mczerski/MySXRelay/snapshots/front.png

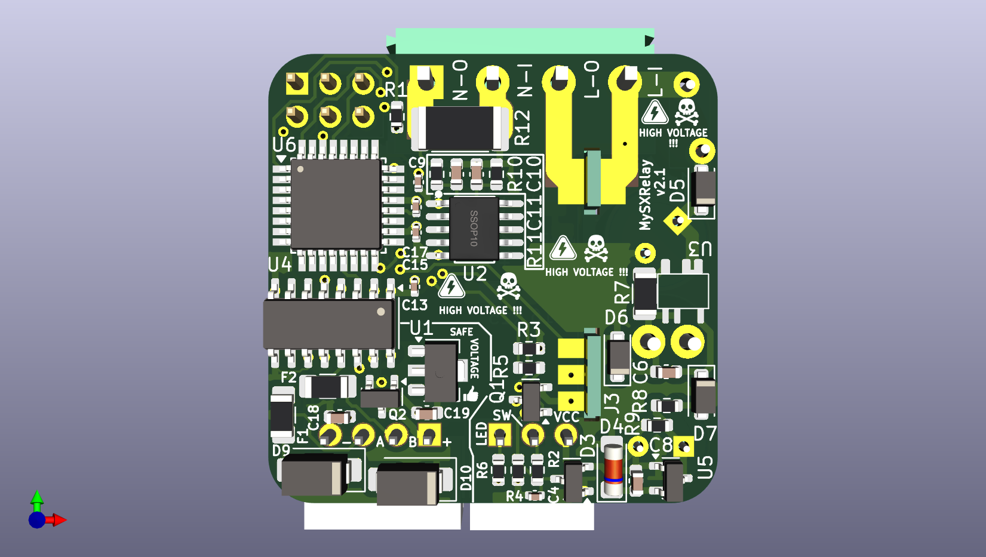
snapshots/front.png
