mczerski/MySXRelay/snapshots/bottom.png

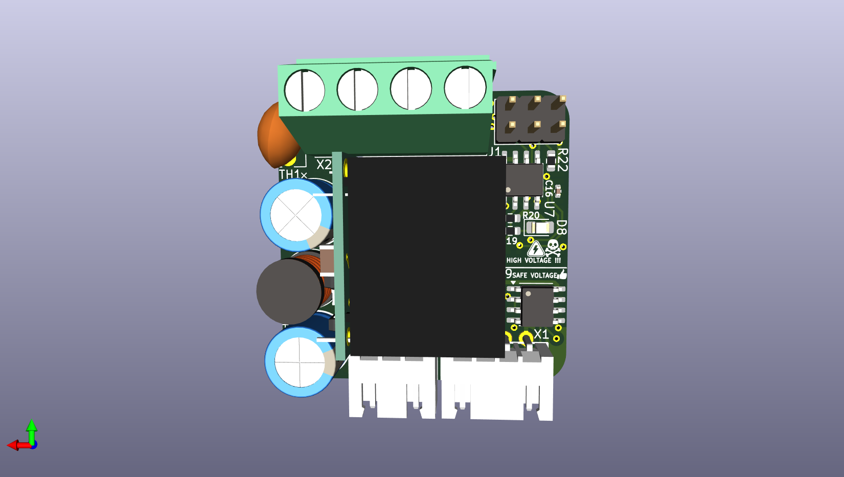
snapshots/bottom.png
