mczerski/MySXRelay/snapshots/bottom-1.png

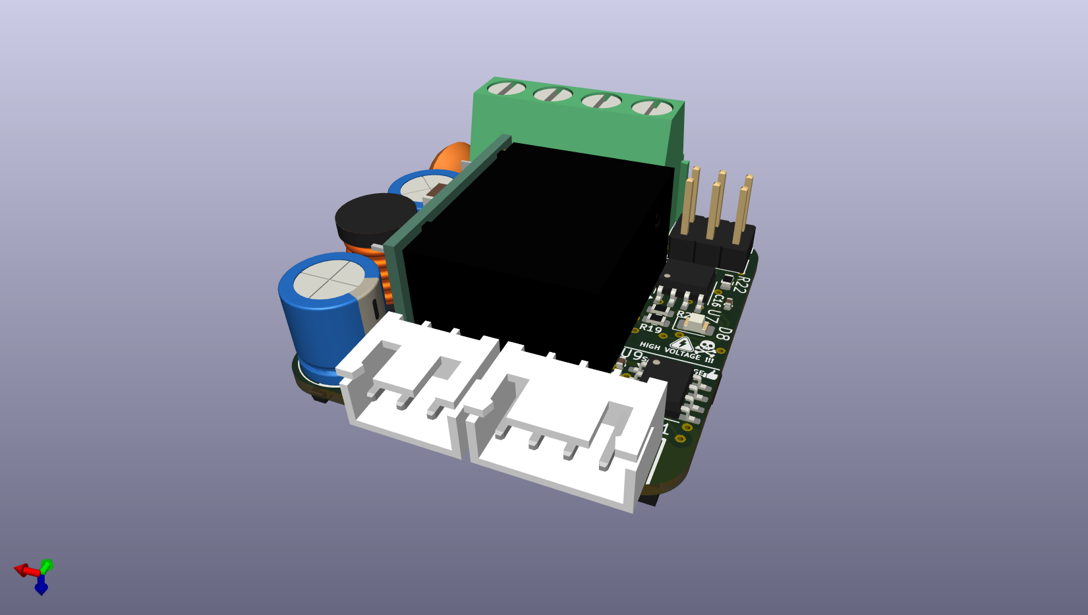
snapshots/bottom-1.png
