mczerski/MySXRelay/snapshots/bottom-2.png

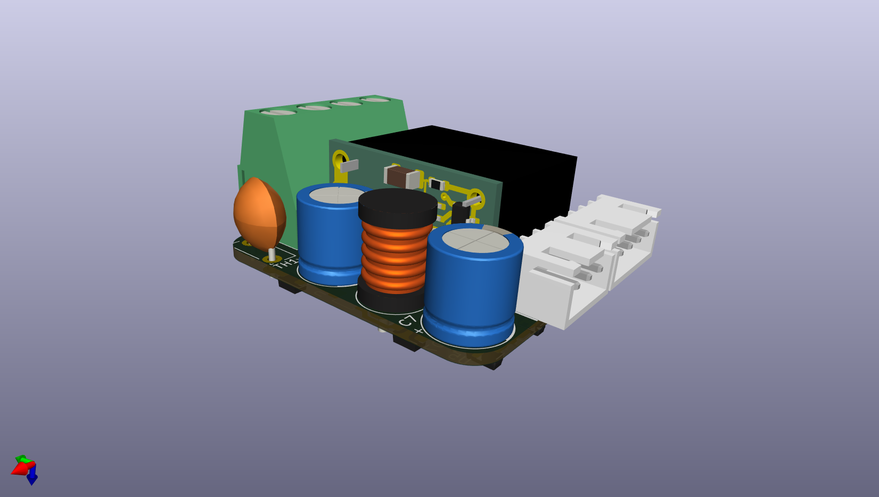
snapshots/bottom-2.png
