mczerski/MySXRelay/snapshots/bottom-3.png

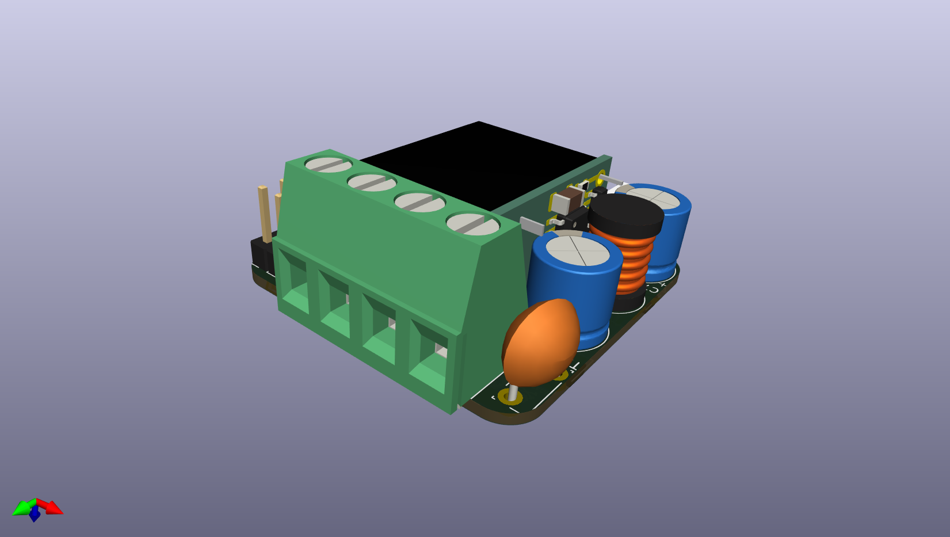
snapshots/bottom-3.png
