mczerski/MySXRelay/snapshots/bottom-4.png

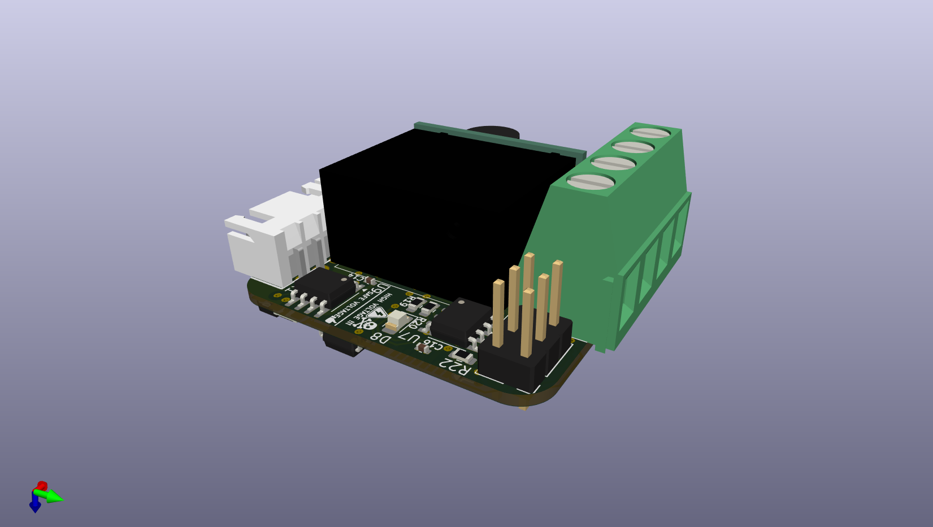
snapshots/bottom-4.png
