mczerski/MySXRelay/snapshots/front-1.png

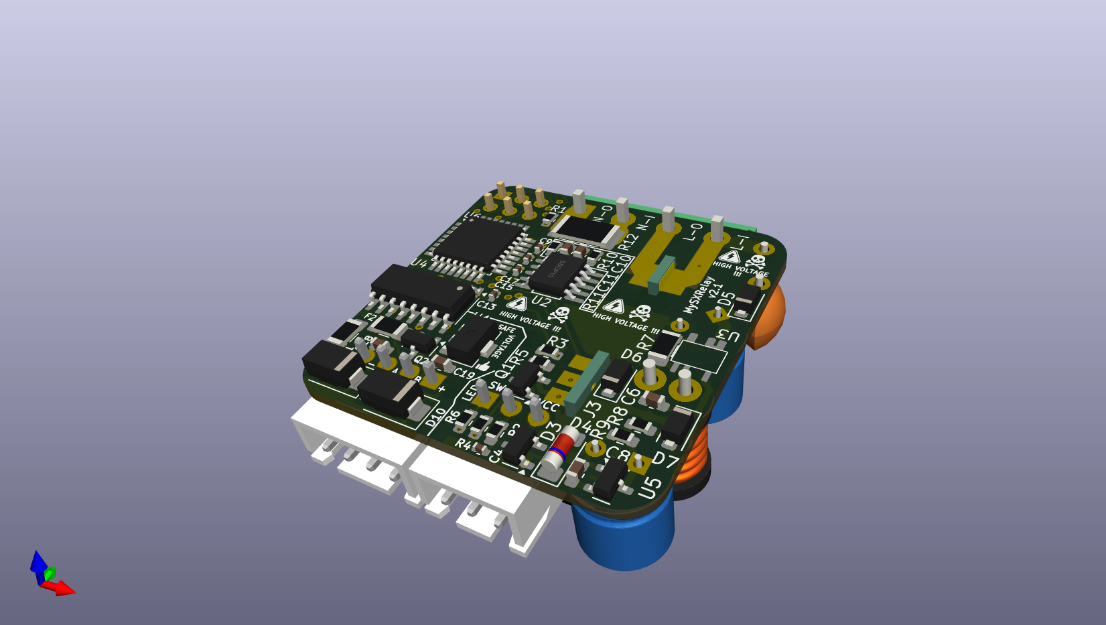
snapshots/front-1.png
