mczerski/MySXRelay/snapshots/front-2.png

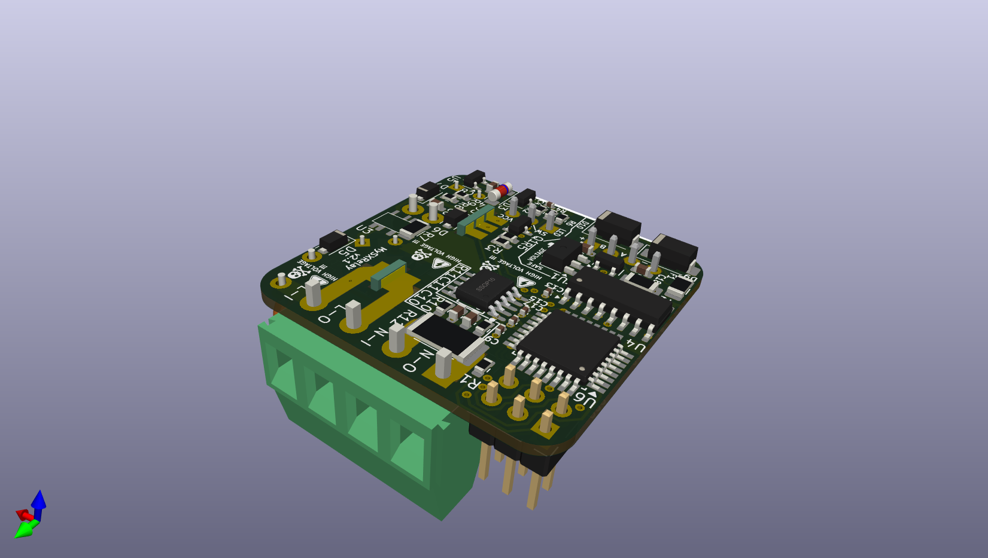
snapshots/front-2.png
