mczerski/MySXRelay/MySXRelay.ods

"Id" | "Oznaczenie" | "Footprint" | "Liczba" | "Oznaczenie" | "Dostawca i numer artykułu" | “Cena/szt” | “Cena”
1 | "R9,R2" | "R_0603_1608Metric" | 2 | "2k" |  | 0.08 | 0.16
2 | "C13,C15,C14,C17,C9,C16" | "C_0402_1005Metric" | 6 | "100n" |  | 0.04 | 0.24
3 | "R19,R6" | "R_0603_1608Metric" | 2 | "1k" |  | 0.08 | 0.16
4 | "U9" | "SOIC-8_3.9x4.9mm_P1.27mm" | 1 | "ST485E" | TME, SP485CN-L, https://www.tme.eu/pl/details/sp485cn-l/uklady-scalone-rs232-rs422-rs485/maxlinear/ | 2.0049 | 2.0049
5 | "U2" | "BL0942" | 1 | "BL0942" | Aliexpress, https://pl.aliexpress.com/item/1005006213868221.html | 2.08 | 2.08
6 | "C8,C19" | "C_0603_1608Metric" | 2 | "10u" |  | 0.12 | 0.24
7 | "U6" | "TQFP-32_7x7mm_P0.8mm" | 1 | "ATmega328PB-A" | TME, ATMEGA328PB-AN, https://www.tme.eu/pl/details/atmega328pb-an/rodzina-avr-8-bit/microchip-technology/ | 8.487 | 8.487
8 | "C10,C11,C12" | "C_0603_1608Metric" | 3 | "68n/16V" |  | 0.2 | 0.6
9 | "D6" | "D_SOD-123F" | 1 | "ES1J/600V" | TME, ES1JSLTR-SMC, https://www.tme.eu/pl/details/es1jsltr-smc/diody-uniwersalne-smd/smc-diode-solutions/es1jsltr/ | 0.1952 | 0.1952
10 | "J3" | "edge_connector" | 1 | "Relay" |  | 11.93 | 11.93
11 | "R1,R4,R3" | "R_0603_1608Metric" | 3 | "10k" |  | 0.08 | 0.24
12 | "R10,R11,R13" | "R_0603_1608Metric" | 3 | "510/1%" | TME, SMD0603-510R-1%, https://www.tme.eu/pl/details/smd0603-510r-1%25/rezystory-smd/royalohm/0603saf5100t5e/ | 0.06 | 0.18
13 | "U5" | "SOT-23" | 1 | "AP2127N-3.3" | TME, AP2120N-3.3TRG1, https://www.tme.eu/pl/details/ap2120n-3.3trg1/stabilizatory-napiecia-nieregulowane-ldo/diodes-incorporated/ | 0.4962 | 0.4962
14 | "U1" | "SOT-89-3" | 1 | "AP2204RA-5.0" | TME, AP2204RA-5.0TRG1, https://www.tme.eu/pl/details/ap2204ra-5.0trg1/stabilizatory-napiecia-nieregulowane-ldo/diodes-incorporated/ | 0.8413 | 0.8413
15 | "Q2" | "SOT-23" | 1 | "BSS84A" | TME, BSS84A-TP, https://www.tme.eu/pl/details/bss84a-tp/tranzystory-z-kanalem-p-smd/micro-commercial-components/ | 0.3876 | 0.3876
16 | "C18,C6" | "C_0603_1608Metric" | 2 | "1u/50V" | TME, CL10A105KB8NNNC, https://www.tme.eu/pl/details/cl10a105kb8nnnc/kondensatory-mlcc-smd/samsung/ | 0.0993 | 0.1986
17 | "D7" | "D_SOD-123F" | 1 | "E1J/600V" | TME, ES1JSLTR-SMC, https://www.tme.eu/pl/details/es1jsltr-smc/diody-uniwersalne-smd/smc-diode-solutions/es1jsltr/ | 0.1952 | 0.1952
18 | "D4" | "D_MiniMELF" | 1 | "3.6V" | TME, ZMM3.6-DIO, https://www.tme.eu/pl/details/zmm3.6-dio/diody-zenera-smd/diotec-semiconductor/zmm3-6/ | 0.0904 | 0.0904
19 | "U4" | "SOIC-16_3.9x9.9mm_P1.27mm" | 1 | "Si8642BB-B-IS1" | TME, PAI142M31, https://www.tme.eu/pl/details/pai142m31/uklady-scalone-interfejsy-pozostale/2pai-semi/p142m31/ | 7.6137 | 7.6137
20 | "D5" | "D_SOD-123F" | 1 | "1n4007/1000V" | TME, 1N4007FLTR-SMC, https://www.tme.eu/pl/details/1n4007fltr-smc/diody-uniwersalne-smd/smc-diode-solutions/1n4007fltr/ | 0.5093 | 0.5093
21 | "R12" | "R_2512_6332Metric_Pad1.40x3.35mm_HandSolder" | 1 | "0R001/1%" | TME, LR2512-R001-1%-2W, https://www.tme.eu/pl/details/lr2512-r001-1%25-2w/rezystory-smd/royalohm/lr122wf100nt4e/ | 1.3665 | 1.3665
22 | "U3" | "SOT-33-5A" | 1 | "BP2525X" | Aliexpress, https://pl.aliexpress.com/item/1005005266072461.html | 1.1 | 1.1
23 | "D8" | "LED_0805_2012Metric_Pad1.15x1.40mm_HandSolder" | 1 | "LED" |  | 0.274 | 0.274
24 | "R8" | "R_0603_1608Metric" | 1 | "100" |  | 0.08 | 0.08
25 | "R7" | "R_1206_3216Metric" | 1 | "0R3" | TME, ERJ8BQFR30V, https://www.tme.eu/pl/details/erj8bqfr30v/rezystory-smd/panasonic/ | 0.5984 | 0.5984
26 | "D10,D9" | "D_SMA" | 2 | "SMAJ11CA" | TME, SMAJ11CA-13-F, https://www.tme.eu/pl/details/smaj11ca-13-f/diody-tvs-smd-dwukierunkowe/diodes-incorporated/ | 0.4207 | 0.8414
27 | "R22,R20" | "R_0603_1608Metric" | 2 | "1M" |  | 0.08 | 0.16
28 | "C5" | "CP_Radial_D8.0mm_P3.50mm" | 1 | "2.2u/400V" | TME, GRC00PB2R22WTFL, https://www.tme.eu/pl/details/grc00pb2r22wtfl/kondensatory-elektrolityczne-tht/vishay/ | 0.7161 | 0.7161
29 | "R14,R18,R16,R17,R15" | "R_1206_3216Metric" | 5 | "390k/1%" | TME, SMD1206-390K-1%, https://www.tme.eu/pl/details/smd1206-390k-1%25/rezystory-smd/royalohm/1206s4f3903t5e/ | 0.10065 | 0.50325
30 | "J1" | "PinHeader_2x03_P2.54mm_Vertical" | 1 | "AVR ISP" |  | 0.26 | 0.26
31 | "X3" | "JST-XH_S_3P-2.54MM" | 1 | "Switch/LED" | Allegro, https://allegro.pl/oferta/jst-xh-2-54mm-3pin-wtyczka-z-kablami-gniazdo-katowe-14981161904 | 2.6 | 2.6
32 | "F2,F1" | "Fuse_1206_3216Metric_Pad1.42x1.75mm_HandSolder" | 2 | "Polyfuse" | TME, PTS120660V005, https://www.tme.eu/pl/details/pts120660v005/bezpieczniki-polimerowe-smd/eaton-bussmann/ | 0.5793 | 1.1586
33 | "U7" | "SOIC-8_3.9x4.9mm_P1.27mm" | 1 | "AT25xxx" | TME, GD25D05BTIG, https://www.tme.eu/pl/details/gd25d05btig/pamieci-flash-szeregowe/gigadevice/ | 0.524 | 0.524
34 | "TH1" | "Fuse_Bourns_MF-RG300" | 1 | "ERF-LX005V2" | TME, LX005-V2, https://www.tme.eu/pl/details/lx005-v2/bezpieczniki-polimerowe-tht/ece/erf-lx005v2/ | 1.0529 | 1.0529
35 | "Q1" | "SOT-23" | 1 | "2N7002" | TME, 2N7002A-DIO, https://www.tme.eu/pl/details/2n7002a-dio/tranzystory-z-kanalem-n-smd/diotec-semiconductor/2n7002a/ | 0.1684 | 0.1684
36 | "C4" | "C_0402_1005Metric" | 1 | "100n/50V" | TME, GCM155R71H104KE02D, https://www.tme.eu/pl/details/gcm155r71h104ke02d/kondensatory-mlcc-smd/murata/ | 0.0758 | 0.0758
37 | "C7" | "CP_Radial_D8.0mm_P3.50mm" | 1 | "470u/10V" | TME, PF1A471MNN08B5, https://www.tme.eu/pl/details/pf1a471mnn08b5/kondensatory-elektrolityczne-tht/elite/ | 0.2723 | 0.2723
38 | "L1" | "L_Radial_D7.0mm_P3.00mm" | 1 | "330u" | TME, COIL0507-0.33, https://www.tme.eu/pl/details/coil0507-0.33/dlawiki-pionowe/ferrocore/ | 1.4674 | 1.4674
39 | "X2" | "TerminalBlock_Phoenix_MKDS-1,5-4-5.08_1x04_P5.08mm_Horizontal" | 1 | "Mains" | TME, XY301V-2P, https://www.tme.eu/pl/details/xy301v-2p/listwy-zaciskowe-do-druku/xinya/xy301v-2p-5-00/ | 1.1224 | 1.1224
40 | "D3" | "SOT-23" | 1 | "BAT54S" | TME, BAT54S, https://www.tme.eu/pl/details/bat54s-dio/diody-schottky-smd/diotec-semiconductor/bat54s/ | 0.1535 | 0.1535
41 | "X1" | "JST-XH_S_4P-2.54MM-PIN1-RIGHT" | 1 | "RS485" | Allegro, https://allegro.pl/oferta/jst-xh-2-54mm-4pin-wtyczka-z-kablami-gniazdo-katowe-14981142802 | 2.8 | 2.8
42 | "R5" | "R_0603_1608Metric" | 1 | "27" |  | 0.08 | 0.08
43 | PCB |  | 1 |  | Jlcpcb | 1.2185 | 1.2185
 |  |  |  |  |  |  | 55.44285 | Suma
