mczerski/MySXRelay/3dshapes/bistable-relay.step

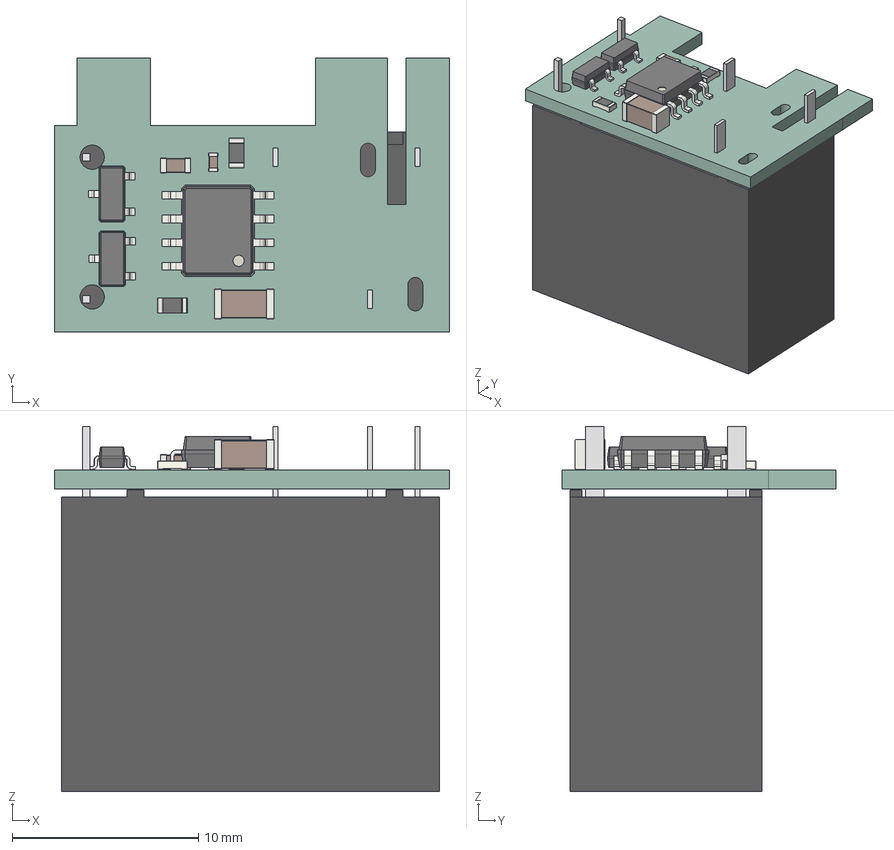
[picture p9: CAD file, 2026-10-02]
3dshapes/bistable-relay.step
21.2 x 14.7 x 19.6 mm
C_0603_1608Metric
C_1206_3216Metric
R_0603_1608Metric x 2
SOT_23 x 2
SOIC_8_39x49mm_P127mm
C_0402_1005Metric
G5Q_14_EU
bistable-relay_PCB
