mczerski/MySXRelay/3dshapes/JST - XH - Thru (R) - 2Pin - 2.54mm.stp

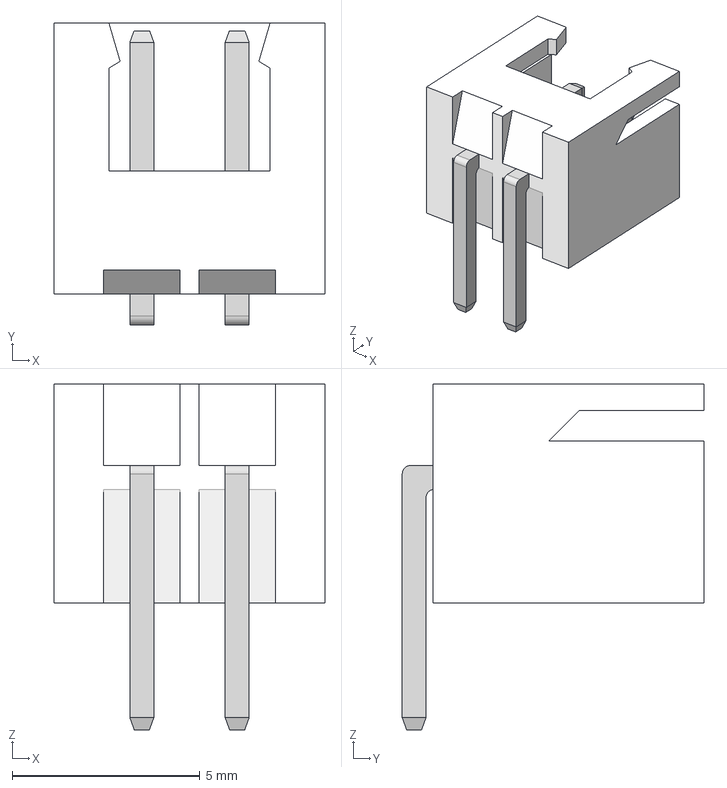
[picture p10: CAD file, 2026-09-26]
3dshapes/JST - XH - Thru (R) - 2Pin - 2.54mm.stp
7.21 x 8.04 x 9.22 mm
