mczerski/MySXRelay/3dshapes/EFR-LX005V2.step

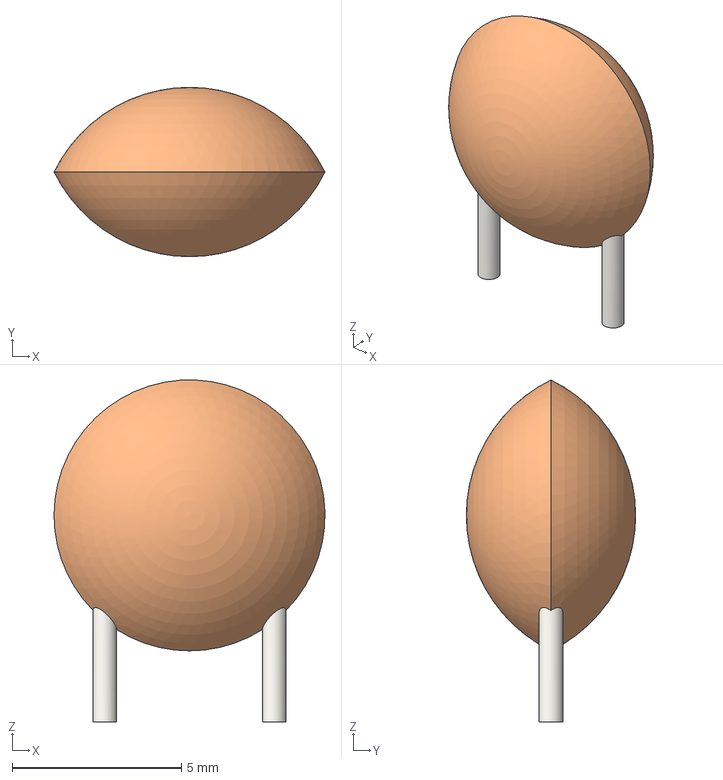
[picture p11: CAD file, 2024-11-26]
3dshapes/EFR-LX005V2.step
8.00 x 5.00 x 10.1 mm
