mczerski/MySXRelay/3dshapes/JST - XH - Thru (R) - 4Pin - 2.54mm.stp

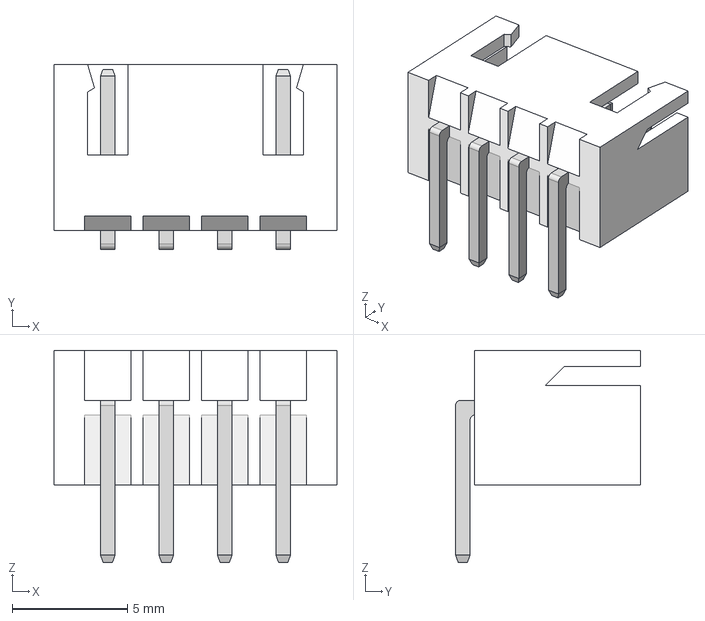
[picture p12: CAD file, 2024-11-03]
3dshapes/JST - XH - Thru (R) - 4Pin - 2.54mm.stp
12.3 x 8.04 x 9.22 mm
