mczerski/MySXRelay/3dshapes/JST - XH - Thru (R) - 3Pin - 2.54mm.stp

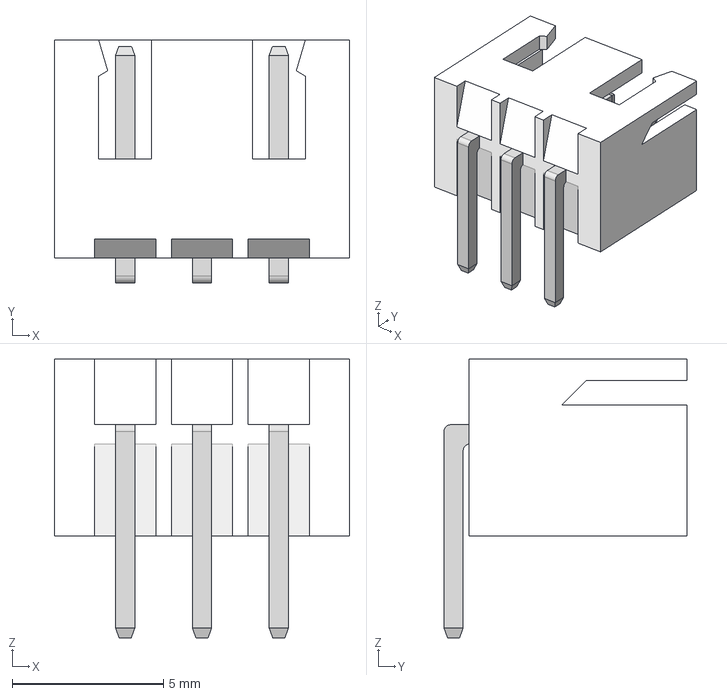
[picture p13: CAD file, 2024-11-03]
3dshapes/JST - XH - Thru (R) - 3Pin - 2.54mm.stp
9.75 x 8.04 x 9.22 mm
