mczerski/MySXRelay/3dshapes/MSTB_2,5_4-G.stp

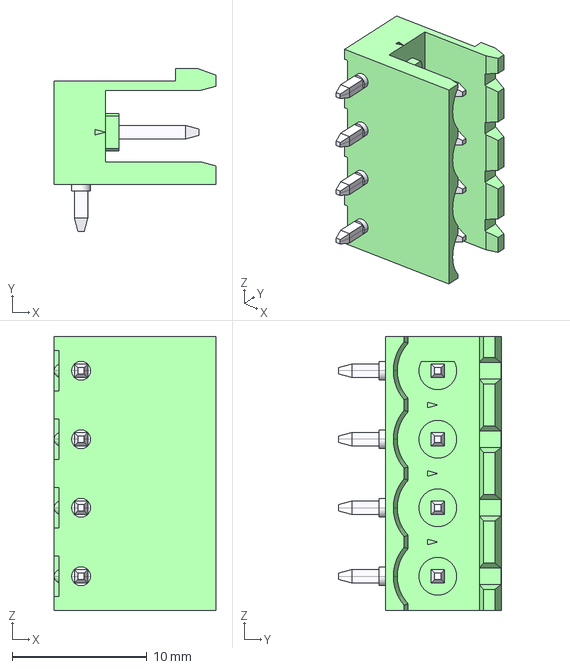
[picture p14: CAD file, 2024-10-23]
3dshapes/MSTB_2,5_4-G.stp
12.0 x 12.1 x 20.3 mm
