mczerski/MySXRelay/doc/ROYALOHM-FRN.pdf

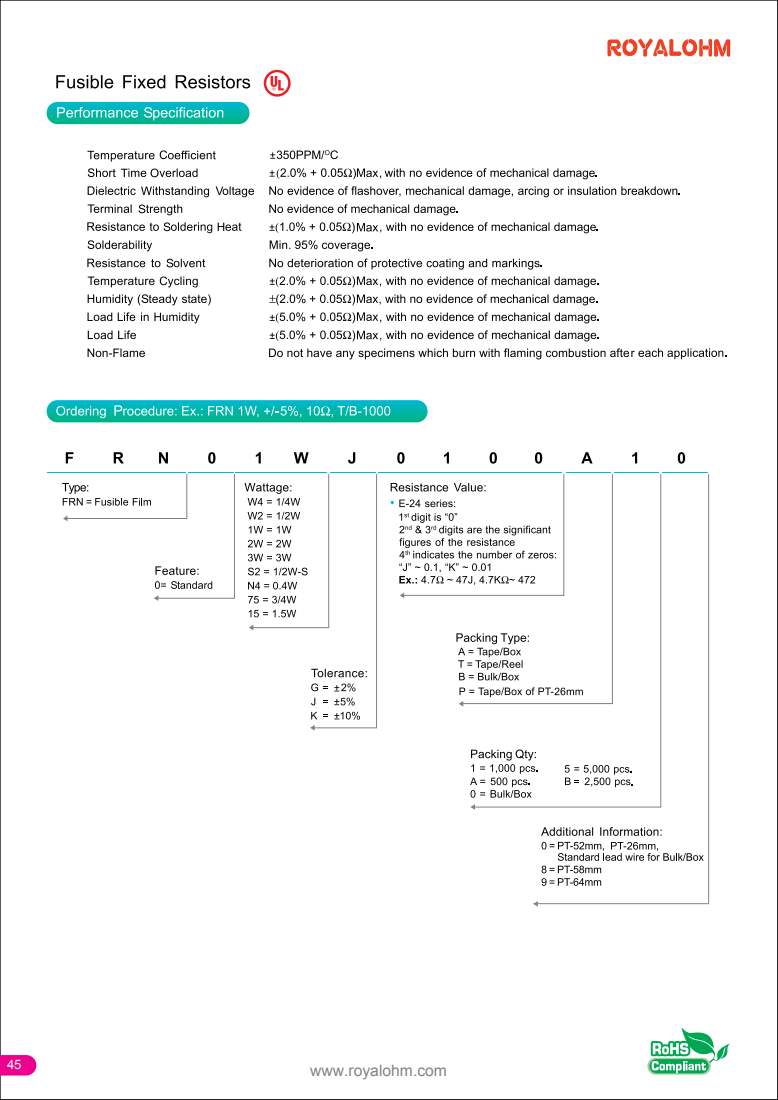
[picture p15: page 1]
www.royalohm.com

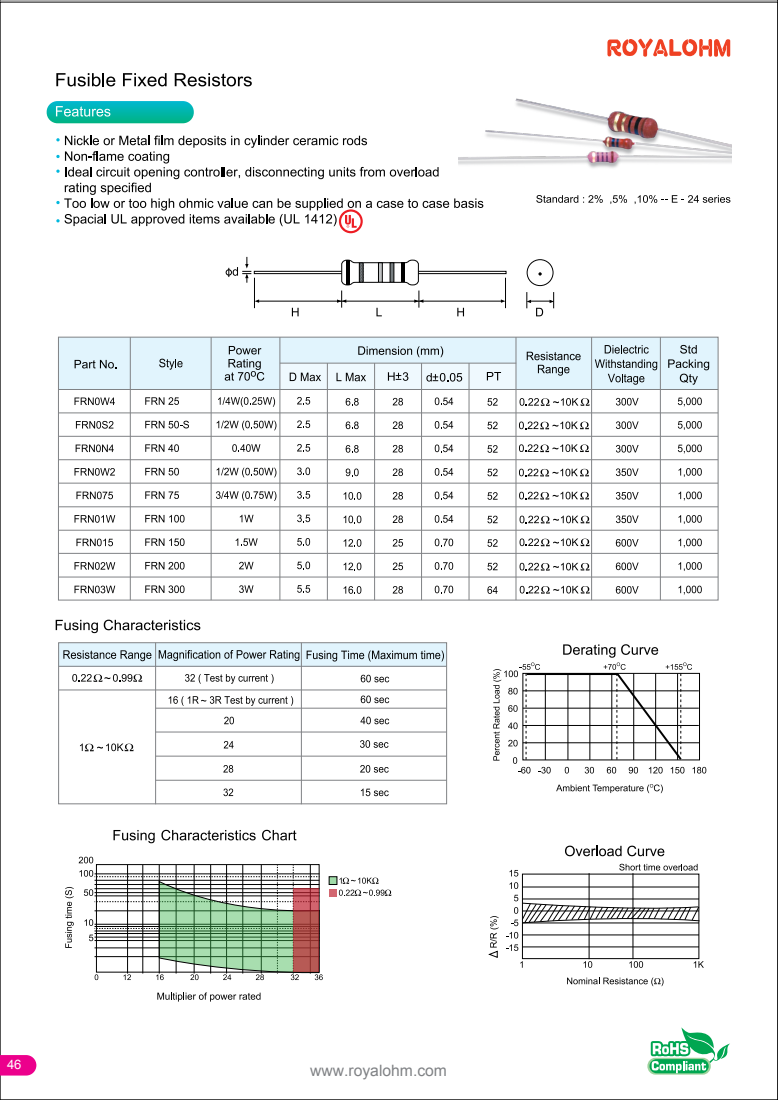
[picture p16: page 2]
www.royalohm.com
