mczerski/MySXRelay/MySXRelay.kicad_pcb

## KiCad design MySXRelay.kicad_pcb (2026-10-02)

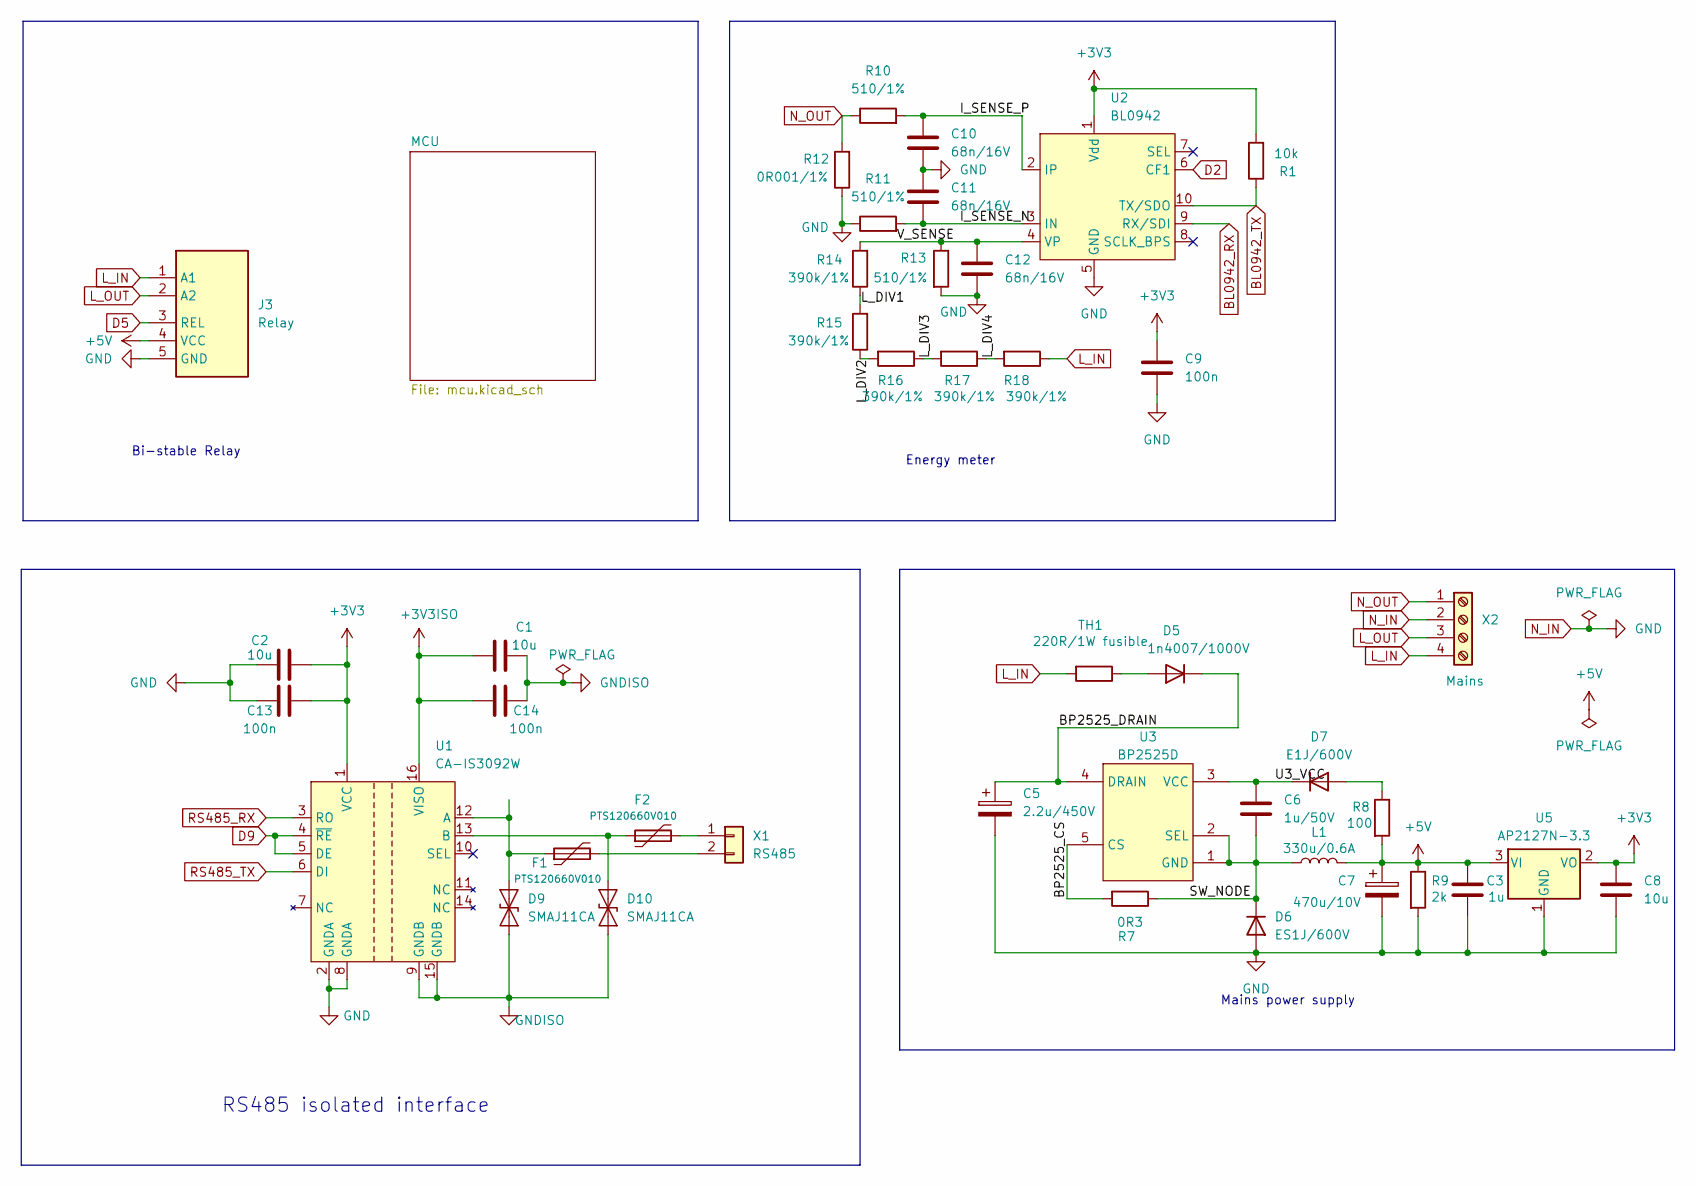
[picture p17: schematic MySXRelay.kicad_sch]

Parts:
C1, C2, C8: 10u; C_0603_1608Metric
C3: 1u; C_0603_1608Metric
C5: 2.2u/450V; CP_Radial_D8.0mm_P3.50mm
C6: 1u/50V; C_0603_1608Metric
C7: 470u/10V; CP_Radial_D8.0mm_P3.50mm
C9, C13, C14: 100n; C_0402_1005Metric
C10, C11, C12: 68n/16V; C_0603_1608Metric
D5: 1n4007/1000V; D_SOD-123F
D6: ES1J/600V; D_SOD-123F
D7: E1J/600V; D_SOD-123F
D9, D10: SMAJ11CA; D_SMA
F1, F2: PTS120660V010; Fuse_1206_3216Metric_Pad1.42x1.75mm_HandSolder
J3: Relay; edge_connector
L1: 330u/0.6A; L_Radial_D7.5mm_P3.00mm_Ferrocore_COIL0608
R1: 10k; R_0603_1608Metric
R7: 0R3; R_1206_3216Metric
R8: 100; R_0603_1608Metric
R9: 2k; R_0603_1608Metric
R10, R11, R13: 510/1%; R_0603_1608Metric
R12: 0R001/1%; R_2512_6332Metric_Pad1.40x3.35mm_HandSolder
R14, R15, R16, R17, R18: 390k/1%; R_1206_3216Metric
TH1: 220R/1W fusible; R_Axial_DIN0207_L6.3mm_D2.5mm_P5.08mm_Vertical
U1: CA-IS3092W; SOIC-16W_7.5x10.3mm_P1.27mm
U2: BL0942
U3: BP2525D; SOT-33-5A
U5: AP2127N-3.3; SOT-23
X1: RS485; JST-XH_S_2P-2.54MM
X2: Mains; TerminalBlock_Phoenix_MKDS-1,5-4-5.08_1x04_P5.08mm_Horizont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

Connections:
+3V3: C2.2, C8.1, C9.1, C13.2, R1.2, U1.1 (VCC), U2.1 (Vdd), U5.2 (VO); also elsewhere on the board
+3V3ISO: C1.1, C14.1, U1.16 (VISO)
+5V: C3.1, C7.1, J3.4 (VCC), L1.2, R8.2, R9.1, U5.3 (VI)
/BP2525_CS: R7.2, U3.5 (CS)
/BP2525_DRAIN: C5.1, D5.1 (K), U3.4 (DRAIN)
/I_SENSE_N: C11.2, R11.2, U2.3 (IN)
/I_SENSE_P: C10.1, R10.2, U2.2 (IP)
/L_DIV1: R14.1, R15.2
/L_DIV2: R15.1, R16.2
/L_DIV3: R16.1, R17.2
/L_DIV4: R17.1, R18.2
/SW_NODE: C6.2, D6.1 (K), L1.1, R7.1, U3.1 (GND), U3.2 (SEL)
/U3_VCC: C6.1, D7.1 (K), U3.3 (VCC)
/V_SENSE: C12.1, R13.1, R14.2, U2.4 (VP)
BL0942_RX: U2.9 (RX/SDI); also elsewhere on the board
BL0942_TX: R1.1, U2.10 (TX/SDO); also elsewhere on the board
D2: U2.6 (CF1); also elsewhere on the board
D5: J3.3 (REL); also elsewhere on the board
D9: U1.4 (~RE), U1.5 (DE); also elsewhere on the board
GNDISO: C1.2, C14.2, D9.1 (A1), D10.1 (A1), U1.9 (GNDB), U1.15 (GNDB)
L_IN: J3.1 (A1), R18.1, TH1.2, X2.4
L_OUT: J3.2 (A2), X2.3
N_IN: C2.1, C3.2, C5.2, C7.2, C8.2, C9.2, C10.2, C11.1, C12.2, C13.1, D6.2 (A), J3.5 (GND), R9.2, R11.1, R12.1, R13.2, U1.2 (GNDA), U1.8 (GNDA), U2.5 (GND), U5.1 (GND), X2.2; also elsewhere on the board
N_OUT: R10.1, R12.2, X2.1
unnamed: D5.2 (A), TH1.1
unnamed: D7.2 (A), R8.1
unnamed: D9.2 (A2), F1.1, U1.12 (A)
unnamed: D10.2 (A2), F2.1, U1.13 (B)
unnamed: F2.2, X1.1
unnamed: F1.2, X1.2
RS485_RX: U1.3 (RO); also elsewhere on the board
RS485_TX: U1.6 (DI); also elsewhere on the board

Notes on the sheet:
RS485 isolated interface
Mains power supply
Energy meter
Bi-stable Relay

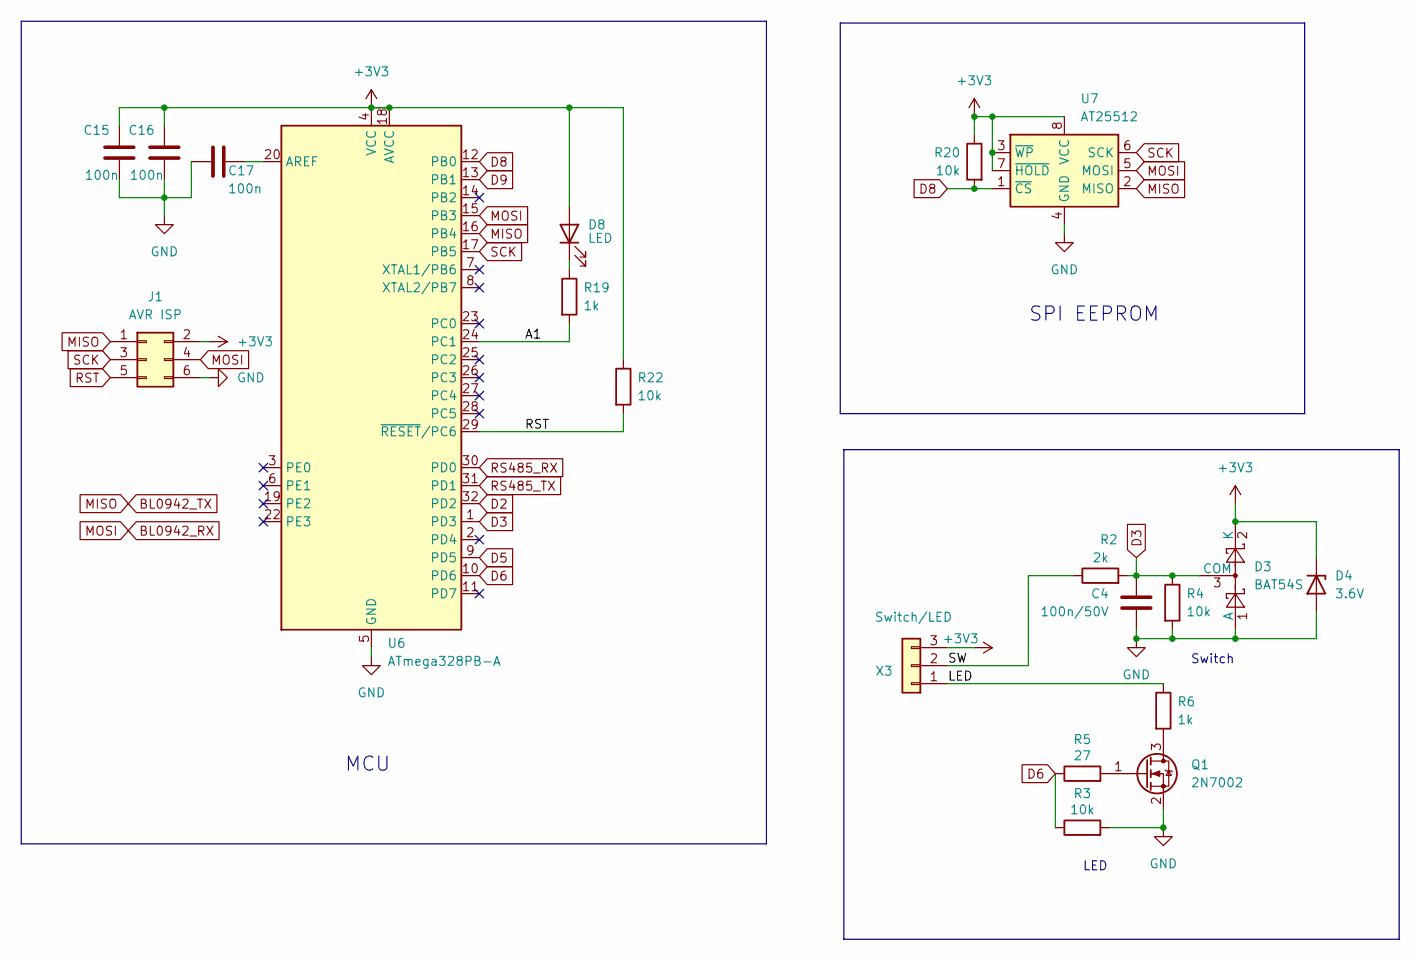
[picture p18: schematic mcu.kicad_sch]

Parts:
C4: 100n/50V; C_0402_1005Metric
C15, C16, C17: 100n; C_0402_1005Metric
D3: BAT54S; SOT-23
D4: 3.6V; D_MiniMELF
D8: LED; LED_0805_2012Metric_Pad1.15x1.40mm_HandSolder
J1: AVR ISP; PinHeader_2x03_P2.54mm_Vertical
Q1: 2N7002; SOT-23
R2: 2k; R_0603_1608Metric
R3, R4, R20, R22: 10k; R_0603_1608Metric
R5: 27; R_0603_1608Metric
R6, R19: 1k; R_0603_1608Metric
U6: ATmega328PB-A; TQFP-32_7x7mm_P0.8mm
U7: AT25512; SOIC-8_3.9x4.9mm_P1.27mm
X3: Switch/LED; JST-XH_S_3P-2.54MM

Connections:
+3V3: C15.1, C16.1, D3.2 (K), D4.1 (K), D8.2 (A), J1.2, R20.1, R22.1, U6.4 (VCC), U6.18 (AVCC), U7.3 (~WP), U7.7 (~HOLD), U7.8 (VCC), X3.3; also elsewhere on the board
/MCU/A1: R19.2, U6.24 (PC1)
/MCU/LED: R6.1, X3.1
/MCU/SW: R2.1, X3.2
BL0942_RX: J1.4, U6.15 (PB3), U7.5 (MOSI); also elsewhere on the board
BL0942_TX: J1.1, U6.16 (PB4), U7.2 (MISO); also elsewhere on the board
D2: U6.32 (PD2); also elsewhere on the board
D3: C4.1, D3.3 (COM), R2.2, R4.1, U6.1 (PD3)
D5: U6.9 (PD5); also elsewhere on the board
D6: R3.1, R5.1, U6.10 (PD6)
D8: R20.2, U6.12 (PB0), U7.1 (~CS)
D9: U6.13 (PB1); also elsewhere on the board
N_IN: C4.2, C15.2, C16.2, C17.2, D3.1 (A), D4.2 (A), J1.6, Q1.2 (S), R3.2, R4.2, U6.5 (GND), U6.21 (GND), U7.4 (GND); also elsewhere on the board
unnamed: D8.1 (K), R19.1
unnamed: Q1.3 (D), R6.2
unnamed: Q1.1 (G), R5.2
unnamed: C17.1, U6.20 (AREF)
RS485_RX: U6.30 (PD0); also elsewhere on the board
RS485_TX: U6.31 (PD1); also elsewhere on the board
RST: J1.5, R22.2, U6.29 (~RESET/PC6)
SCK: J1.3, U6.17 (PB5), U7.6 (SCK)

Notes on the sheet:
Switch
SPI EEPROM
LED
MCU

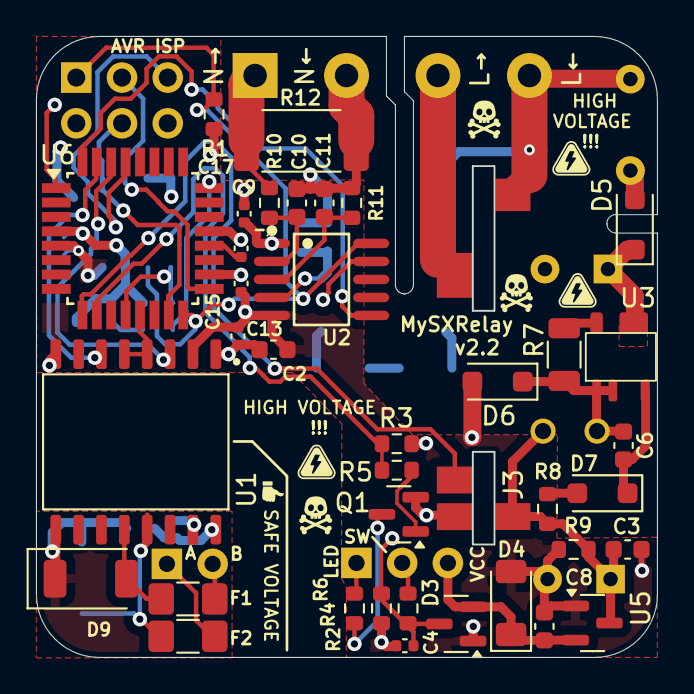
[picture p19: board MySXRelay.kicad_pcb from above]

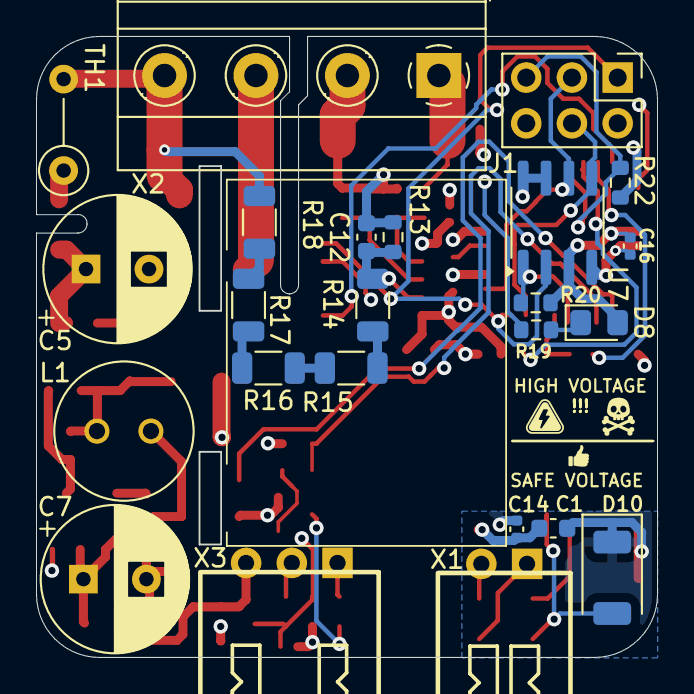
[picture p20: board MySXRelay.kicad_pcb from below]

Board: 4 copper layers, 34.5 x 34.5 mm, 62 parts (24 on the bottom side), 44 nets.
