mczerski/MySXRelay/(commit log)

2024-10-12 initiall schematic
    [MySXRelay.kicad_pcb, MySXRelay.kicad_sch]
2024-10-14 finished schematic
    [MySXRelay.kicad_pcb, MySXRelay.kicad_sch]
2024-10-16 add LDO on mains power supply output
    [MySXRelay.kicad_pcb, MySXRelay.kicad_sch]
2024-10-16 setup PCS dimensions
    [MySXRelay.kicad_pcb, MySXRelay.kicad_sch]
2024-10-28 PCB WIP
    [MySXRelay.kicad_pcb, MySXRelay.kicad_sch]
2024-10-28 WIP PCB
    [MySXRelay.kicad_pcb, MySXRelay.kicad_sch]
2024-11-03 PCB placment and routing finished
    [JST - XH - Thru (R) - 3Pin - 2.54mm.stp, JST - XH - Thru (R) - 4Pin - 2.54mm.stp, MySXRelay.kicad_pcb, MySXRelay.kicad_sch]
2024-11-03 version 1.0
    [MySXRelay.kicad_pcb]
2024-11-24 update schematic to new version
    - include MCU, remove MySXMotherboard
    - only RS485 interface is isolated
    [MySXRelay.kicad_pcb, MySXRelay.kicad_sch, mcu.kicad_sch]
2024-11-25 update pcb (WIP)
    [MySXRelay.kicad_pcb, MySXRelay.kicad_sch, bistable-relay.step]
2024-11-26 relay module updated
    [MySXRelay.kicad_pcb, MySXRelay.kicad_sch, bistable-relay.step]
2024-11-26 finished PCB
    [MySXRelay.kicad_pcb]
2024-12-04 changed mains connector
    [MySXRelay.kicad_pcb, MySXRelay.kicad_sch]
2024-12-06 finish PCB afterr changing connector
    [MySXRelay.kicad_pcb]
2024-12-13 change AP2204 to AP2202
    [MySXRelay.kicad_pcb, MySXRelay.kicad_sch]
2024-12-13 remove BL0942 TX pin jumper and add pull up resistor
    [MySXRelay.kicad_pcb, MySXRelay.kicad_sch, mcu.kicad_sch]
2024-12-16 change RS485 interface LDO package to sot-89
    [MySXRelay.kicad_pcb, MySXRelay.kicad_sch]
2024-12-24 shrink PCB to fit 40mmx40mm HM-1551V1WH case
    [MySXRelay.kicad_pcb]
2024-12-24 add BOM + update schematic parts descriptions
    [MySXRelay.kicad_pcb, MySXRelay.kicad_sch, MySXRelay.ods, mcu.kicad_sch]
2024-12-25 add high voltage cutouts
    [MySXRelay.kicad_pcb]
2025-01-11 fix part numbers positions on silcscreen
    [MySXRelay.kicad_pcb]
2025-01-14 move vias out of pads and cover vies with soldermask
    [MySXRelay.kicad_pcb]
2026-09-26 fix part names and datasheet links
    [MySXRelay.kicad_sch, mcu.kicad_sch]
2026-09-26 replace RS485 low voltage side with single isolated transciever chip CA-IS3092W
    [JST - XH - Thru (R) - 2Pin - 2.54mm.stp, MySXRelay.kicad_pcb, MySXRelay.kicad_sch, mcu.kicad_sch]
2026-10-02 rework for proper clearence distances
    [MySXRelay.kicad_pcb, MySXRelay.kicad_sch, bistable-relay.step, mcu.kicad_sch]
